Project-CETI/whale-tag-recovery/hardware/WhaleTagRecovery_3v2r1_BOM.xlsx

No. | Quantity | Comment | Designator | Footprint | Value | Manufacturer Part | Manufacturer | Supplier Part | Supplier | Datasheet | Description | LCSC Part Name | JLCPCB Part Class | Voltage Rated | Voltage | Add into BOM | LCSC Stock | LCSC Price | JLCPCB Stock | JLCPCB Price | Name
1 | 1 | MS621FE-FL11E | BT1 | MS621FE-FL11E |  |  |  |  |  |  |  |  |  |  |  | yes |  |  |  |  | MS621FE-FL11E
2 | 1 | 1uF | C1 | C0402 | 1uF | CC0402KRX5R7BB105 | YAGEO(国巨) | C325464 | LCSC | https://atta.szlcsc.com/upload/public/pdf/source/20181031/C325464_552E8C5A0F4FE3FC31E3609DB4A74E24.pdf | Capacitance: Tolerance:±10% Tolerance:±10% Voltage Rated: Temperature Coefficient: | 1uF ±10% 16V | Extended Part |  |  | yes | 106100 | 0.0038 | 22270 | 0.0249 | 1uF
3 | 1 | 10uF | C2 | C0603 |  | GRM188R60G106ME47D | muRata(村田) | C97885 | LCSC |  |  |  | ExtendedPart |  |  | yes | 1100 | 0.0171 | 1781 | 0.117 | 10uF
4 | 1 | 100nF | C4 | C0402 | 100nF | GCM155R71C104KA55J | muRata(村田) | C2655418 | LCSC | https://atta.szlcsc.com/upload/public/pdf/source/20210701/42090801FDE37D0E45AFF657247F4A08.pdf | Capacitance: Tolerance:±10% Tolerance:±10% Voltage Rated: Temperature Coefficient: | 100nF ±10% 16V | Extended Part |  |  | yes | 700 | 0.0058 | 4903 | 0.0388 | 100nF
5 | 1 | 100nF | C5 | C0402 |  | CC0402ZRY5V7BB104 | YAGEO(国巨) | C106209 | LCSC |  |  |  | ExtendedPart |  |  | yes | 511900 | 0.0013 | 94523 | 0.00825 | 100nF
6 | 2 | 1uF | C6,C15 | C0402 |  | GRM155R61E105KA12D | muRata(村田) | C77009 | LCSC |  |  |  | ExtendedPart |  |  | yes | 937595 | 0.0057 | 444510 | 0.0383 | 1uF
7 | 1 | 100uF | C7 | C1210 |  | GRM32ER60J107ME20L | muRata(村田) | C88154 | LCSC |  |  |  | ExtendedPart |  |  | yes | 112580 | 0.1098 | 26608 | 0.751 | 100uF
8 | 9 | 100nF | C8,C9,C10,C11,C12,C13,C14,C17,C23 | C0402 |  | GRM155R71C104KA88D | muRata(村田) | C71629 | LCSC |  |  |  | ExtendedPart |  |  | yes |  |  | 689637 | 0.00981 | 100nF
9 | 1 | 10nF | C16 | C0402 |  | GRM155R71H103KA88D | muRata(村田) | C77019 | LCSC |  |  |  | ExtendedPart |  |  | yes | 651884 | 0.0020 | 450964 | 0.0137 | 10nF
10 | 1 | 4.7uF | C18 | C0603 |  | GRM188R61A475KE15D | muRata(村田) | C71633 | LCSC |  |  |  | ExtendedPart |  |  | yes |  |  | 1607 | 0.0563 | 4.7uF
11 | 2 | 15pF | C19,C20 | C0402 |  | GJM1555C1H150FB01D | muRata(村田) | C441742 | LCSC |  |  |  | ExtendedPart |  |  | yes |  |  | 9774 | 0.134 | 15pF
12 | 2 | 6pF | C21,C22 | C0402 |  | GCM1555C1H6R0BA16D | muRata(村田) | C437443 | LCSC |  |  |  | ExtendedPart |  |  | yes | 800 | 0.0158 | 1091 | 0.106 | 6pF
13 | 4 | 0Ω | C,C28,D,L5 | R0402 | 0Ω | ERJ2GE0R00X | PANASONIC(松下) | C242160 | LCSC | https://atta.szlcsc.com/upload/public/pdf/source/20181106/C242160_CA6E41971DE5A1DCD79442F3CF334CD6.pdf | Type:Thick Film Resistors Resistance: Power(Watts): Overload Voltage (Max):- Temperature Coefficient:-100ppm/℃~+600ppm/℃ Temperature Coefficient:-100ppm/℃~+600ppm/℃ Operating Temperature Range:-55℃~+155℃ Operating Temperature Range:-55℃~+155℃,Type:Thick Film Resistors Resistance: Power(Watts): Overload Voltage (Max):- Temperature Coefficient:-100ppm/℃~+600ppm/℃ Temperature Coefficient:-100ppm/℃~+600ppm/℃ Operating Temperature Range:-55℃~+155℃ Operating Temperature Range:-55℃~+155℃ | 0Ω 100mW 厚膜电阻 | Extended Part |  |  | yes |  | 0.0036 | 0 | 0.024 | 0Ω
14 | 1 | SS14L | D1 | SMA_L4.4-W2.6-LS5.0-RD |  | SS14L_R1_00001 | PANJIT(强茂) | C125883 | LCSC |  |  |  | ExtendedPart |  |  | yes | 3300 | 0.0596 | 3536 | 0.399 | SS14L
15 | 1 | 16-213/BHC-ZL1M2B6Y/3T | D2 | LED0402-RD_BLUE |  | 16-213/BHC-ZL1M2B6Y/3T | EVERLIGHT(亿光) | C2844007 | LCSC |  |  |  | ExtendedPart |  |  | yes | 124060 | 0.0288 | 119474 | 0.193 | 16-213/BHC-ZL1M2B6Y/3T
16 | 1 | 16-213/SDRC/S530-A3/TR8 | D3 | LED0402-RD |  | 16-213SDRC/S530-A3/TR8 | EVERLIGHT(亿光) | C71911 | LCSC |  |  |  | ExtendedPart |  |  | yes |  |  | 21515 | 0.32 | 16-213/SDRC/S530-A3/TR8
17 | 2 | 1909763-1 | J1,J2 | ANT-SMD_1909763-1 |  | 1909763-1 | TEConnectivity(美国泰科) | C392444 | LCSC |  |  |  | ExtendedPart |  |  | yes | 10 | 0.2992 | 148 | 2.0463 | 1909763-1
18 | 1 | TC2030-IDC-NL | J3 | TC2030-IDC-NL |  |  |  |  |  |  |  |  |  |  |  | yes |  |  |  |  | TC2030-IDC-NL
19 | 1 | CASTELLATION-0.05&quot;-W/-TH | J4 | CASTELLATION-0.05\"-W/-TH |  |  |  |  |  |  |  |  |  |  |  | yes |  |  |  |  | CASTELLATION-0.05&quot;-W/-TH
20 | 1 | Ferrite Bead | L1 | L0603 | 120R | BLM18PG121SN1D | muRata(村田) | C14709 | LCSC |  |  |  | ExtendedPart |  |  | yes |  |  | 167327 | 0.0416 | Ferrite Bead
21 | 1 | CI160808-27NJ | L2 | IND_BOURNS_CI160808 |  |  |  |  |  |  |  |  |  |  |  | yes |  |  |  |  | CI160808-27NJ
22 | 1 | LQW15AN9N1J00D_ | L4 | INDC1006X60N |  |  |  |  |  |  |  |  |  |  |  | yes
23 | 2 | DMN65D8L-7 | Q1,Q2 | SOT-23-3_L3.0-W1.7-P0.95-LS2.9-BR |  | DMN65D8L-7 | DIODES(美台) | C155341 | LCSC |  |  |  | ExtendedPart |  |  | yes | 10500 | 0.0248 | 10693 | 0.169 | DMN65D8L-7
24 | 1 | SSM3J332R,LF | Q3 | SOT-23F_L2.9-W1.8-P0.95-LS2.4-BR |  | SSM3J332R,LF | TOSHIBA | C146367 | LCSC |  |  |  | ExtendedPart |  |  | yes | 101700 | 0.0438 | 89033 | 0.299 | SSM3J332R,LF
25 | 3 | 1k | R1,R2,R7 | R0603 |  |  |  |  |  |  |  |  |  |  |  | yes |  |  |  |  | 1k
26 | 1 | 10Ω | R3 | R0603 | 10Ω | ESR03EZPJ100 | ROHM(罗姆) | C253327 | LCSC | https://atta.szlcsc.com/upload/public/pdf/source/20180719/C253345_B76D5E071FE5F975028EF7B0C44FE2A9.pdf | Type:Thick Film Resistors Resistance: Tolerance:±5% Tolerance:±5% Power(Watts):250mW Overload Voltage (Max): Temperature Coefficient:±200ppm/℃ Temperature Coefficient:±200ppm/℃ Operating Temperature Range:-55℃~+155℃ Operating Temperature Range:-55℃~+155℃ | 厚膜电阻 10Ω ±5% 250mW | Extended Part |  |  | yes |  | 0.0076 | 447 | 0.0508 | 10Ω
27 | 3 | 10k | R4,R15,R30 | R0603 |  | RC0603FR-0710KL |  |  | LCSC |  |  |  |  |  |  | yes |  |  |  |  | 10k
28 | 2 | 0 Ohm | R5,R16 | R0603 |  | 0603WAF0000T5E |  |  | LCSC |  |  |  |  |  |  | yes |  |  |  |  | 0 Ohm
29 | 4 | 75k | R6,R12,R13,R14 | R0603 |  | RC0603FR-0775KL |  |  |  |  |  |  |  |  |  | yes |  |  |  |  | 75k
30 | 2 | 330Ω | R8,R9 | R0603 | 330Ω | RC0603JR-07330RL | YAGEO(国巨) | C105879 | LCSC | https://atta.szlcsc.com/upload/public/pdf/source/20170705/1499242708629.pdf | Type:Thick Film Resistors Resistance: Tolerance:±5% Tolerance:±5% Power(Watts): Overload Voltage (Max): Temperature Coefficient:±100ppm/℃ Temperature Coefficient:±100ppm/℃ Operating Temperature Range:-55℃~+155℃ Operating Temperature Range:-55℃~+155℃ | 厚膜电阻 330Ω ±5% 100mW | Extended Part |  |  | yes | 89392 | 0.0010 | 34052 | 0.00633 | 330Ω
31 | 1 | 10k | R24 | R0402 |  | TR0402D10KQ1025 |  |  | LCSC |  |  |  |  |  |  | yes |  |  |  |  | 10k
32 | 1 | 4.22k | R25 | R0402 |  | RT0402BRD074K22L |  |  | LCSC |  |  |  |  |  |  | yes |  |  |  |  | 4.22k
33 | 1 | 15k | R26 | R0402 |  | 0402WGF1502TCE |  |  | LCSC |  |  |  |  |  |  | yes |  |  |  |  | 15k
34 | 1 | DRA818V | U1 | DORJI_DRA818V |  |  |  |  |  |  |  |  |  |  |  | yes |  |  |  |  | DRA818V
35 | 1 | NEO-M9N-00B | U2 | GPSM-SMD_24P-L16.0-W12.2-P1.10-BL |  | NEO-M9N-00B | null | C5119087 | LCSC |  |  |  | ExtendedPart |  |  | yes |  | 41.1692 | 0 | 276 | NEO-M9N-00B
36 | 1 | {ManufacturerPart!} | U3 | LQFP-100_L14.0-W14.0-P0.50-LS16.0-BL |  | STM32U575VGT6 | ST(意法半导体) | C5270988 | LCSC |  |  | STM32U575VGT6 | ExtendedPart |  |  | yes | 6182 | 5.4415 | 3071 | 36.48 | {ManufacturerPart!}
37 | 1 | SKY65943-11 | U6 | MCM-10_L2.5-W2.5-P0.50-BL-EP |  | SKY65943-11 | SKYWORKS | C2654442 | LCSC |  | Frequency Range:1.559GHz~1.606GHz Frequency Range:1.559GHz~1.606GHz Applications:Galileo,GLONASS,GNSS,GPS | SKY65943-11 | Extended Part |  |  | yes |  | 15.6638 | 0 | 105 | SKY65943-11
38 | 1 | 32.768kHz | X1 | OSC-SMD_L3.2-W1.5 |  | X321532768KGD2SI | YXC(扬兴晶振) | C620155 | LCSC |  |  |  | ExtendedPart |  |  | yes | 114945 | 0.1826 | 42698 | 1.25 | 32.768kHz
39 | 1 | 16MHz | X2 | CRYSTAL-SMD_4P-L2.5-W2.0-BL-A |  | NX2520SA-16MHZ-STD-CSW-5 | NDK | C280836 | LCSC |  |  |  | ExtendedPart |  |  | yes | 5092 | 0.3790 | 5247 | 2.54 | 16MHz
