Project-CETI/whale-tag-recovery/(threads)

Thread 4 (2022-08-01):

Sleep RP2040 chip when not being used

SSModelGit, 2022-08-01:
Assuming no RX of APRS messages, we want to leverage the sleep capabilities of the RP2040 so that we are using as little power as possible. Ideally, we use a timer to set when the chip should wake up, and at all other times it hibernates at the lowest power mode.

kellyostrom, 2022-08-25:
This requires fixing an IRQ usage issue on the RP2040, currently when waking from the sleep it will eventually kernel panic for running out of available user IRQs. The lowlevel internal call for restoring the gpio IRQ after the sleep does not appear to be freeing properly, will need more investigation before this can be fully implemented in a way that rewakes the RP2040.

msalinoh, 2024-01-17:
Implementing low power mode is still relevant to STM32 based board.

Sources to wakeup during idle state:
1) receiving UART command from host board
1) critical battery voltage (switch to shutdown state)
1) WDT, failure to receive communication from host board in 10 minutes (switch to active state)

Sources to wakeup during active state:
1) transmit timer
1) receiving UART command from host board
1) receiving UART from GPS chip
1) critical battery voltage (switch to shutdown state)

Updated issue title

Thread 6 (2022-08-01):

Measure board power consumption with sleep modes enabled

SSModelGit, 2022-08-01:
When #3, #4, and #5 are implemented, hook up a meter and measure how much power is being consumed by the board to document what power levels we need to use.

kellyostrom, 2022-08-25:
With everything in a deep sleep/powered entirely down, we are at about 0.1Ws of passive consumption. It's possible we can get this even lower, but this is our deep sleep benchmark as of now.

Thread 8 (2022-08-01):

Add latitude frequency switch to Tag 2

SSModelGit, 2022-08-01:
- [ ] Compile a binary using the new `aprs.c` file with the old `swarm.c` file.
- [ ] Check that nothing breaks post compilation.
- [ ] Verify that the latitude frequency switch now occurs post compilation.

kellyostrom, 2022-08-25:
No longer using swarm

Closed 2022-08-25.

Thread 9 (2022-08-01):

Fix global variable use

SSModelGit, 2022-08-01:
Adapt the code to use less global variables and make memory access more controlled so that the eventual switch to state-machine-based interrupts does not cause errors.

kellyostrom, 2022-08-17:
Created constants file to store the important #defines and static consts that is then shared throughout the various configs

Closed 2022-08-17.

Thread 13 (2022-08-25):

PIO for APRS sine wave generation

kellyostrom, 2022-08-25:
Currently the sine wave for the APRS transmissions are using a simply loop functionality with a busy wait. There are some concerns that there is error delay accumulating from this as per #12, and if that's true, if the PIO could be used to generate the sine wave instead because of the higher precision in terms of timing. The PIO would allow better syncing with the clock to have a more accurate sine wave.

msalinoh, 2024-01-17:
No longer relevant to latest STM32 based recovery board. Sinewave generation handled via DAC DMA with clock scaling for precise timing.

Closed 2024-01-17.

Thread 14 (2022-08-25):

Compressed AX.25 messages for APRS

kellyostrom, 2022-08-25:
Currently we are using the standard message configuration for the AX.25 messages, however it may be beneficial to use the compressed message format to ensure the length of our transmission in terms of data is shorter. However, the positions in the compressed messages have less accuracy than the standard format.

msalinoh, 2024-01-17:
Compressed APRS location information now implemented.

Closed 2024-01-17.

Thread 19 (2024-01-17):

Implement WDT while in idle mode

msalinoh, 2024-01-17:
Currently the recovery board is placed into an idle state via uart command when the host whale tag detects it is in a dive as GPS and APRS communication is not possible underwater. Currently the only way out of this state is via uart command from the whale tag. This runs the risk that if the tag dies while on a dive, the recovery board will never become active making retrieval much more difficult.

- [ ] Implement a watchdog timer (WDT) that will automatically switch the tag into recovery mode after 10 minutes
- [ ] Reset WDT when we receive a valid uart command from the host whale tag
