Project-CETI/whale-tag-recovery/hardware/WhaleTagRecovery_3v2r1_Schematic.pdf

VDD 50 | PB12 51 PB13 52 PB14 53 PB15 54 PD8 55 PD9 56 PD10 57 PD11 58 PD12 59 PD13 60 PD14 61 PD15 62 PC6 63 PC7 64 PC8 65 PC9 66 PA8 67 PA9 68 PA10 69 PA11 70 PA12 71 PA13 72 VDDUSB 73 VSS 74 VDD 75 PA14 76 PA15 77 PC10 78 PC11 79 PC12 80 PD0 81 PD1 82 PD2 83 PD3 84 PD4 85 PD5 86 PD6 87 PD7 88 PB3 89 PB4 90 PB5 91 PB6 92 PB7 93 PH3-BOOTO 94 PB8 95 PB9 96 PE0 97 PE1 98 VSS 99 VDD 100
LSE Crystal | HSE Crystal

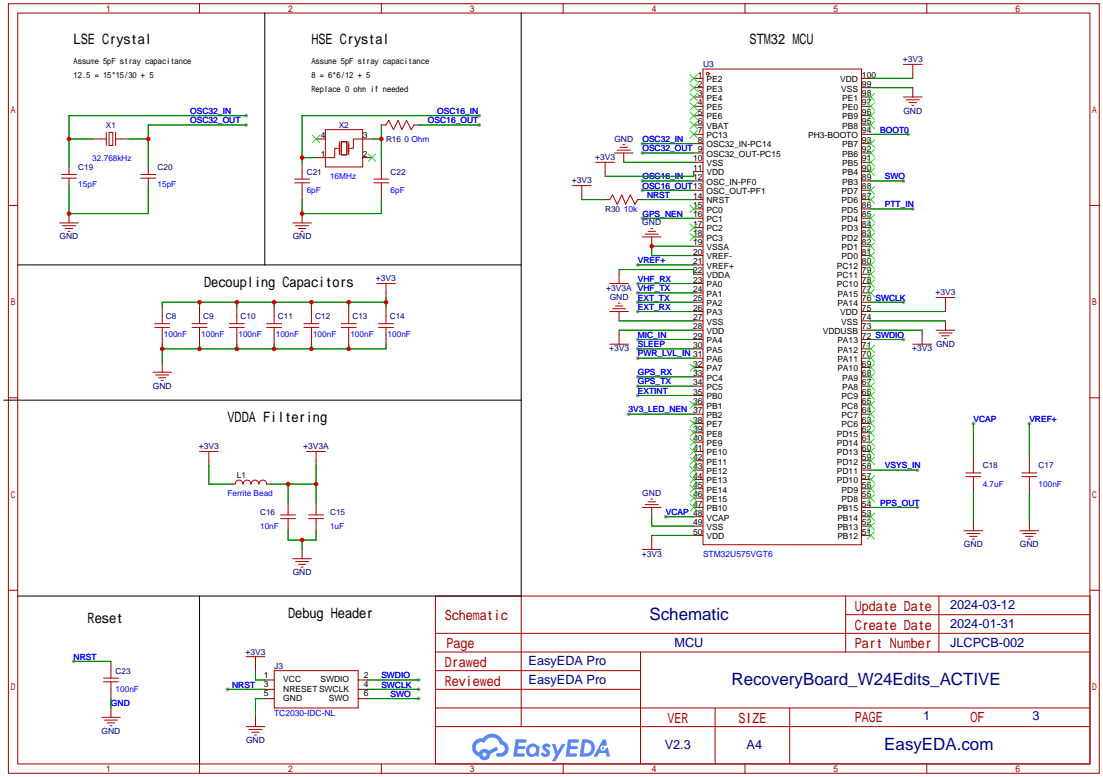
[picture p3: page 1]

Assume 5pF stray capacitance
Replace 0 ohm if needed

VHF Transceiver | GPS Module

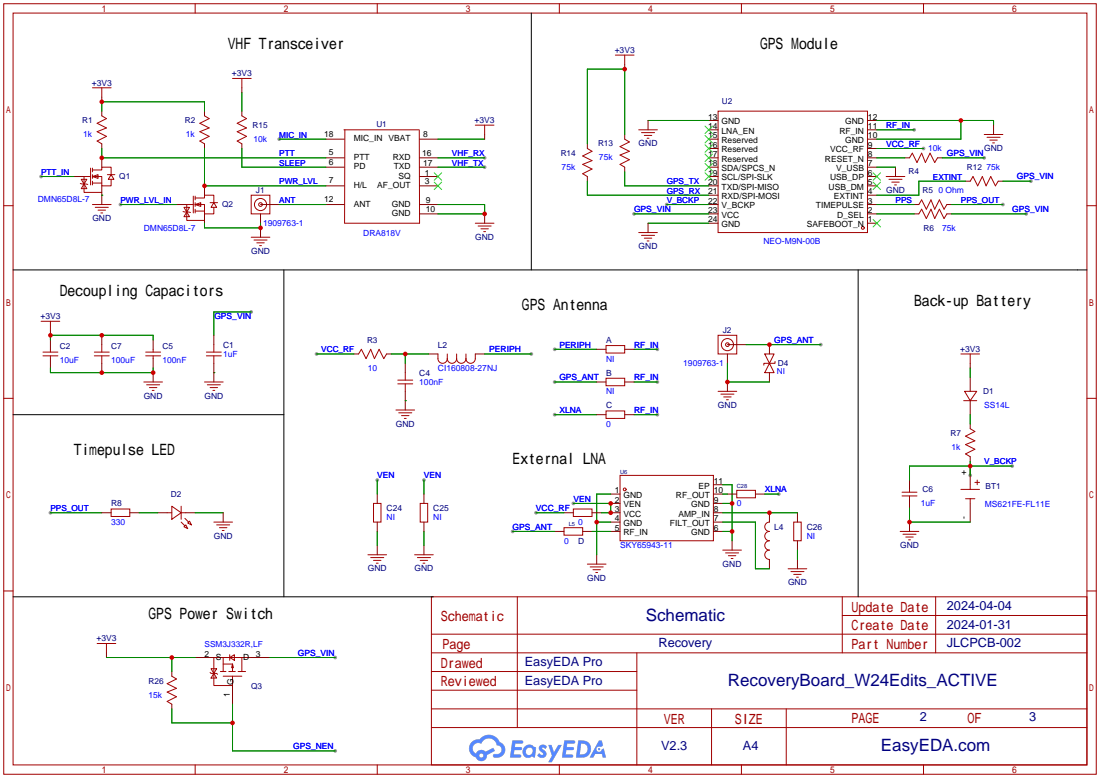
[picture p4: page 2]

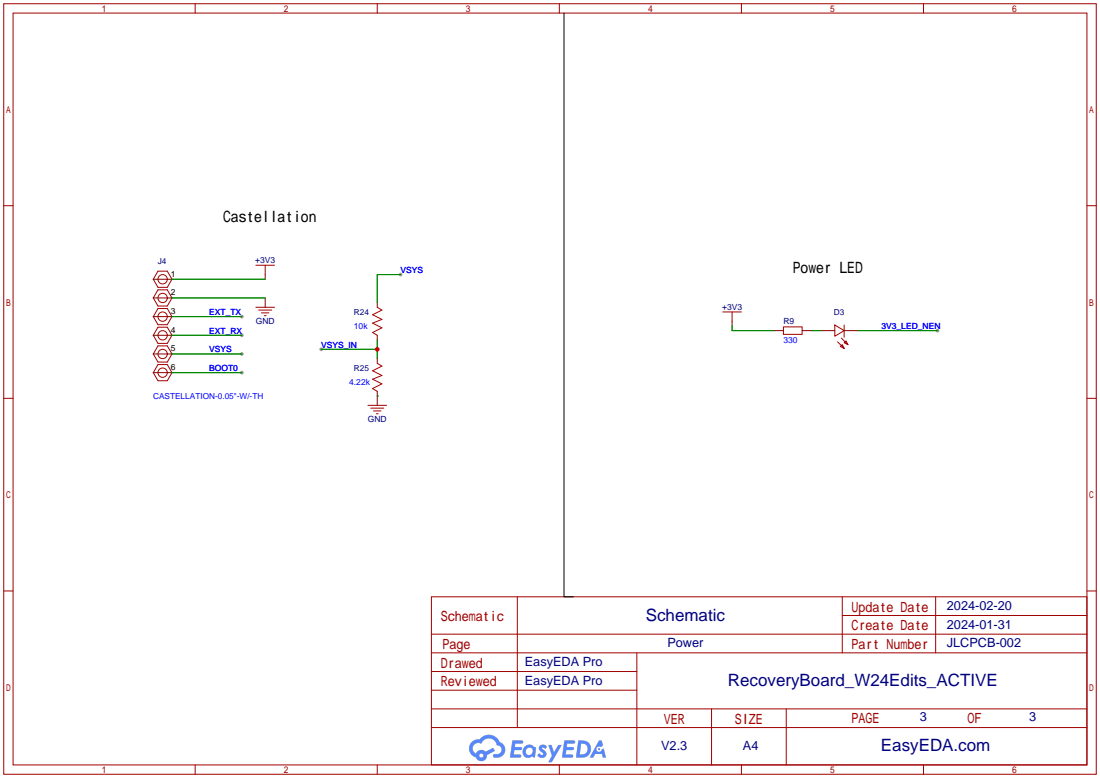
[picture p5: page 3]
