Project-CETI/whale-tag-recovery/(list of files, drawings)

Other design files:
hardware/WhaleTagRecovery_3v2r1_EasyEDA.epro
