Project-CETI/whale-tag-recovery/WhaleTagRecovery/Core/Src/main.c

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
/* Includes ------------------------------------------------------------------*/
#include "app_threadx.h"
#include "main.h"

/* USER CODE BEGIN Includes */
#include "config.h"
#include "Recovery Inc/Gps.h"
#include "Comms Inc/PiComms.h"
/* USER CODE END Includes */

/* USER CODE BEGIN PM */
#define BOOTLOADER_ADDRESS     0x0BF90000
/* USER CODE END PM */

ADC_HandleTypeDef hadc4;

DAC_HandleTypeDef hdac1;
DMA_NodeTypeDef Node_GPDMA1_Channel1;
DMA_QListTypeDef List_GPDMA1_Channel1;
DMA_HandleTypeDef handle_GPDMA1_Channel1;

TIM_HandleTypeDef htim2;

UART_HandleTypeDef huart4;
UART_HandleTypeDef huart2;
UART_HandleTypeDef huart3;
DMA_HandleTypeDef handle_GPDMA1_Channel2;
DMA_NodeTypeDef Node_GPDMA1_Channel0;
DMA_QListTypeDef List_GPDMA1_Channel0;
DMA_HandleTypeDef handle_GPDMA1_Channel0;

/* USER CODE BEGIN PV */
VHF_HandleTypdeDef vhf = {
	.huart = &huart4,
	.pd = 	{.port = APRS_PD_GPIO_Port,  .pin = APRS_PD_Pin},
	.h_l = 	{.port = APRS_H_L_GPIO_Port, .pin = APRS_H_L_Pin},
	.ptt = 	{.port = VHF_PTT_GPIO_Port,  .pin = VHF_PTT_Pin},
	.state = VHF_STATE_SLEEP,
	.power_level = VHF_POWER_HIGH,
	.config = {
		.tx_freq_MHz = 144.3900f,
		.rx_freq_MHz = 144.3900f,
		.volume = VHF_VOLUME_LEVEL,
	},
};
/* USER CODE END PV */

void SystemClock_Config(void);
static void SystemPower_Config(void);
static void MX_GPIO_Init(void);
static void MX_GPDMA1_Init(void);
static void MX_DAC1_Init(void);
static void MX_TIM2_Init(void);
static void MX_UART4_Init(void);
static void MX_USART3_UART_Init(void);
static void MX_USART2_UART_Init(void);
static void MX_ADC4_Init(void);
static void MX_ICACHE_Init(void);
/* USER CODE BEGIN 0 */
void HAL_UARTEx_RxEventCallback(UART_HandleTypeDef *huart, uint16_t Size){
	//restarts the DMA listening of the UART rx (next 247 bytes)
	if ( huart->Instance == USART2 ) {
		Pi_RxEventCallback(huart, Size);
	} else if(huart->Instance == USART3){
//		GPS_RxEventCallback(huart, Size);
	}
	return;
}

/* USER CODE END 0 */

/**
  * @brief  The application entry point.
  * @retval int
  */
int main(void)
{

  /* MCU Configuration--------------------------------------------------------*/

  /* Reset of all peripherals, Initializes the Flash interface and the Systick. */
  HAL_Init();

  /* Configure the System Power */
  SystemPower_Config();

  /* Configure the system clock */
  SystemClock_Config();

  /* USER CODE BEGIN SysInit */
#if USB_BOOTLOADER_ENABLED
	// configure PA10 as input
	// read PIN PA10 value, if low enter bootloader
	__HAL_RCC_GPIOA_CLK_ENABLE();
	 GPIO_InitTypeDef GPIO_InitStruct = {
			 .Pin = USB_BOOT_EN_Pin,
			 .Mode = GPIO_MODE_INPUT,
			 .Pull = GPIO_PULLUP
	 };
	 HAL_GPIO_Init(USB_BOOT_EN_GPIO_Port, &GPIO_InitStruct);
	GPIO_PinState bootloader_val = HAL_GPIO_ReadPin(USB_BOOT_EN_GPIO_Port, USB_BOOT_EN_Pin);
	HAL_GPIO_DeInit(USB_BOOT_EN_GPIO_Port, USB_BOOT_EN_Pin);
	__HAL_RCC_GPIOA_CLK_DISABLE(); //disable GPIO clock
	/* JUMP TO SYSTEM MEMORY BOOTLOADER IF PIN IS LOW*/
	if (bootloader_val == GPIO_PIN_RESET) {
		/*Configure GPIO pin Output Level */
		__HAL_RCC_GPIOB_CLK_ENABLE();
		HAL_GPIO_WritePin(PWR_LED_NEN_GPIO_Port, PWR_LED_NEN_Pin, GPIO_PIN_SET);
		GPIO_InitStruct = (GPIO_InitTypeDef){
			.Pin = PWR_LED_NEN_Pin,
			.Mode = GPIO_MODE_OUTPUT_PP,
			.Pull = GPIO_NOPULL,
			.Speed = GPIO_SPEED_FREQ_LOW
		};
		HAL_GPIO_Init(PWR_LED_NEN_GPIO_Port, &GPIO_InitStruct);
		for(int i = 0; i < 2*5; i++){
			HAL_GPIO_TogglePin(PWR_LED_NEN_GPIO_Port, PWR_LED_NEN_Pin);
			HAL_Delay(250);
		}
		HAL_GPIO_DeInit(PWR_LED_NEN_GPIO_Port, PWR_LED_NEN_Pin);
		__HAL_RCC_GPIOB_CLK_DISABLE();
		HAL_DeInit();
		uint32_t BootloaderAddress = *(__IO uint32_t*) (BOOTLOADER_ADDRESS + 4);
		void (* JumpToBootloader)(void) = (void(*)(void)) BootloaderAddress;
		JumpToBootloader();
	}
#endif
  /* USER CODE END SysInit */

  /* Initialize all configured peripherals */
  MX_GPIO_Init();
  MX_GPDMA1_Init();
  MX_DAC1_Init();
  MX_TIM2_Init();
  MX_UART4_Init();
  MX_USART3_UART_Init();
  MX_USART2_UART_Init();
  MX_ADC4_Init();
  MX_ICACHE_Init();
  /* USER CODE BEGIN 2 */
#if BATTERY_MONITOR_ENABLED
  //********************************REQUIRED FOR ADC USE DO NOT REMOVE********************************
  HAL_PWREx_EnableVddA();
#endif
  /* USER CODE END 2 */

  MX_ThreadX_Init();

  /* We should never get here as control is now taken by the scheduler */

  /* Infinite loop */
  /* USER CODE BEGIN WHILE */
  while (1)
  {
    /* USER CODE END WHILE */

    /* USER CODE BEGIN 3 */
  }
  /* USER CODE END 3 */
}

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
/* USER CODE BEGIN 4 */
//Fake timer 2 init function so we can change the period value during runtime
void MX_TIM2_Fake_Init(uint8_t newPeriod){

  TIM_ClockConfigTypeDef sClockSourceConfig = {0};
  TIM_MasterConfigTypeDef sMasterConfig = {0};

  htim2.Instance = TIM2;
  htim2.Init.Prescaler = 16 - 1;
  htim2.Init.CounterMode = TIM_COUNTERMODE_UP;
  htim2.Init.Period = newPeriod - 1;
  htim2.Init.ClockDivision = TIM_CLOCKDIVISION_DIV1;
  htim2.Init.AutoReloadPreload = TIM_AUTORELOAD_PRELOAD_DISABLE;
  if (HAL_TIM_Base_Init(&htim2) != HAL_OK)
  {
	Error_Handler();
  }
  sClockSourceConfig.ClockSource = TIM_CLOCKSOURCE_INTERNAL;
  if (HAL_TIM_ConfigClockSource(&htim2, &sClockSourceConfig) != HAL_OK)
  {
	Error_Handler();
  }
  sMasterConfig.MasterOutputTrigger = TIM_TRGO_UPDATE;
  sMasterConfig.MasterSlaveMode = TIM_MASTERSLAVEMODE_DISABLE;
  if (HAL_TIMEx_MasterConfigSynchronization(&htim2, &sMasterConfig) != HAL_OK)
  {
	Error_Handler();
  }
}
/* USER CODE END 4 */

/**
  * @brief  Period elapsed callback in non blocking mode
  * @note   This function is called  when TIM6 interrupt took place, inside
  * HAL_TIM_IRQHandler(). It makes a direct call to HAL_IncTick() to increment
  * a global variable "uwTick" used as application time base.
  * @param  htim : TIM handle
  * @retval None
  */
void HAL_TIM_PeriodElapsedCallback(TIM_HandleTypeDef *htim)
{
  if (htim->Instance == TIM6) {
    HAL_IncTick();
  }
}

/**
  * @brief  This function is executed in case of error occurrence.
  * @retval None
  */
void Error_Handler(void)
{
  /* USER CODE BEGIN Error_Handler_Debug */
  /* User can add his own implementation to report the HAL error return state */
  __disable_irq();
  while (1)
  {
  }
  /* USER CODE END Error_Handler_Debug */
}

#ifdef  USE_FULL_ASSERT
/**
  * @brief  Reports the name of the source file and the source line number
  *         where the assert_param error has occurred.
  * @param  file: pointer to the source file name
  * @param  line: assert_param error line source number
  * @retval None
  */
void assert_failed(uint8_t *file, uint32_t line)
{
  /* USER CODE BEGIN 6 */
  /* User can add his own implementation to report the file name and line number,
     ex: printf("Wrong parameters value: file %s on line %d\r\n", file, line) */
  /* USER CODE END 6 */
}
#endif /* USE_FULL_ASSERT */
