Project-CETI/whale-tag-recovery/WhaleTagRecovery/WhaleTagRecovery.ioc

Mcu.UserName=STM32U575VGTx
PA0.GPIO_Label=VHF_TX
PA0.Signal=UART4_TX
PA1.GPIO_Label=VHF_RX
PA1.Signal=UART4_RX
PA2.GPIO_Label=EXT_TX
PA2.Signal=USART2_TX
PA3.GPIO_Label=EXT_RX
PA3.Signal=USART2_RX
PA4.Signal=COMP_DAC11_group
PA5.GPIO_Label=APRS_PD
PA5.Signal=GPIO_Output
PA6.GPIO_Label=APRS_H_L
PA6.Signal=GPIO_Output
PB0.GPIO_Label=GPS_EXTINT
PB0.Signal=GPXTI0
PB2.GPIO_Label=PWR_LED_NEN
PB2.Signal=GPIO_Output
PC1.GPIO_Label=GPS_NEN
PC1.Signal=GPIO_Output
PC4.GPIO_Label=GPS_TX
PC4.Signal=USART3_TX
PC5.GPIO_Label=GPS_RX
PC5.Signal=USART3_RX
PD11.GPIO_Label=VSYS_SENSE
PD11.Signal=SharedAnalog_PD11
PD5.GPIO_Label=VHF_PTT
PD5.Signal=GPIO_Output
