Project-CETI/whale-tag-recovery/WhaleTagRecovery/Core/Inc/main.h

#define GPS_NEN_Pin GPIO_PIN_1
#define GPS_NEN_GPIO_Port GPIOC
#define VHF_TX_Pin GPIO_PIN_0
#define VHF_TX_GPIO_Port GPIOA
#define VHF_RX_Pin GPIO_PIN_1
#define VHF_RX_GPIO_Port GPIOA
#define EXT_TX_Pin GPIO_PIN_2
#define EXT_TX_GPIO_Port GPIOA
#define EXT_RX_Pin GPIO_PIN_3
#define EXT_RX_GPIO_Port GPIOA
#define APRS_PD_Pin GPIO_PIN_5
#define APRS_PD_GPIO_Port GPIOA
#define APRS_H_L_Pin GPIO_PIN_6
#define APRS_H_L_GPIO_Port GPIOA
#define GPS_TX_Pin GPIO_PIN_4
#define GPS_TX_GPIO_Port GPIOC
#define GPS_RX_Pin GPIO_PIN_5
#define GPS_RX_GPIO_Port GPIOC
#define GPS_EXTINT_Pin GPIO_PIN_0
#define GPS_EXTINT_GPIO_Port GPIOB
#define PWR_LED_NEN_Pin GPIO_PIN_2
#define PWR_LED_NEN_GPIO_Port GPIOB
#define VSYS_SENSE_Pin GPIO_PIN_11
#define VSYS_SENSE_GPIO_Port GPIOD
#define VHF_PTT_Pin GPIO_PIN_5
#define VHF_PTT_GPIO_Port GPIOD
