Project-CETI/whale-tag-recovery/WhaleTagRecovery/Core/Src/app_threadx.c

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

/* Includes ------------------------------------------------------------------*/
#include "app_threadx.h"

/* USER CODE BEGIN Includes */
#include "Lib Inc/threads.h"
#include "Recovery Inc/Aprs.h"
#include "Recovery Inc/FishTracker.h"
#include <stdint.h>
/* USER CODE END Includes */

/* USER CODE BEGIN PV */
extern Thread_HandleTypeDef threads[NUM_THREADS];
/* USER CODE END PV */

/**
  * @brief  Application ThreadX Initialization.
  * @param memory_ptr: memory pointer
  * @retval int
  */
UINT App_ThreadX_Init(VOID *memory_ptr)
{
  UINT ret = TX_SUCCESS;
  /* USER CODE BEGIN App_ThreadX_MEM_POOL */

	//Initialize thread list so we can create threads
	threadListInit();

	//loop through each thread in the list, allocate the memory and create the stack
	for (uint8_t index = 0; index < NUM_THREADS; index++){

	  VOID * pointer = threads[index].thread_stack_start;
	  // Allocate memory pool
	  TX_BYTE_POOL* byte_pool = (TX_BYTE_POOL*) memory_ptr;
	  ret = tx_byte_allocate(byte_pool, &pointer, threads[index].config.thread_stack_size, TX_NO_WAIT);

  /* USER CODE END App_ThreadX_MEM_POOL */
  /* USER CODE BEGIN App_ThreadX_Init */
	  tx_thread_create(
			  &threads[index].thread,
			  threads[index].config.thread_name,
			  threads[index].config.thread_entry_function,
			  threads[index].config.thread_input,
			  threads[index].thread_stack_start,
			  threads[index].config.thread_stack_size,
			  threads[index].config.priority,
			  threads[index].config.preempt_threshold,
			  threads[index].config.timeslice,
			  threads[index].config.start);
	}

	//TEMP: start the correct thread
#if USE_FISHTRACKER
		tx_thread_resume(&threads[FISHTRACKER_THREAD].thread);
#else
		tx_thread_resume(&threads[STATE_MACHINE_THREAD].thread);
#endif
  /* USER CODE END App_ThreadX_Init */

  return ret;
}

  /**
  * @brief  Function that implements the kernel's initialization.
  * @param  None
  * @retval None
  */
void MX_ThreadX_Init(void)
{
  tx_kernel_enter();

}

/**
  * @brief  App_ThreadX_LowPower_Timer_Setup
  * @param  count : TX timer count
  * @retval None
  */
void App_ThreadX_LowPower_Timer_Setup(ULONG count)
{
  /* USER CODE BEGIN  App_ThreadX_LowPower_Timer_Setup */

  /* USER CODE END  App_ThreadX_LowPower_Timer_Setup */
}

/**
  * @brief  App_ThreadX_LowPower_Enter
  * @param  None
  * @retval None
  */
void App_ThreadX_LowPower_Enter(void)
{
}

/**
  * @brief  App_ThreadX_LowPower_Exit
  * @param  None
  * @retval None
  */
void App_ThreadX_LowPower_Exit(void)
{
}

/**
  * @brief  App_ThreadX_LowPower_Timer_Adjust
  * @param  None
  * @retval Amount of time (in ticks)
  */
ULONG App_ThreadX_LowPower_Timer_Adjust(void)
{
  /* USER CODE BEGIN  App_ThreadX_LowPower_Timer_Adjust */
  return 0;
  /* USER CODE END  App_ThreadX_LowPower_Timer_Adjust */
}
