Project-CETI/whale-tag-recovery/testing/DirectSwarmTests/direct_swarm_connect/direct_swarm_connect.ino

#include "pico/stdlib.h"
#include <stdio.h>

#define MAX_SWARM_MSG_LEN 500

char modem_wr_buf[MAX_SWARM_MSG_LEN];
int modem_wr_buf_pos = 0;

char modem_rd_buf[MAX_SWARM_MSG_LEN];
int modem_rd_buf_pos = 0;
int buf_len = 0;

//char testString[MAX_SWARM_MSG_LEN] = "$RT 1";
char endNmeaString = '*';
uint8_t nmeaCS;

bool bootConfirmed = false;
bool initDTAck = false;

uint8_t nmeaChecksum(const char *sz, size_t len) {
  size_t i = 0;
  uint8_t cs;
  if (sz[0] == '$')
    i++;
  for (cs = 0; (i < len) && sz [i]; i++)
    cs ^= ((uint8_t) sz[i]);
  return cs;
}

int parseModemOutput() {
  if (!bootConfirmed) {
    if (buf_len != 21) {
      return 0; // Can't be BOOT,RUNNING message
    }
    if (modem_rd_buf[6] != 'B') {
      return 0; // Not BOOT sequence
    }
    if (modem_rd_buf[buf_len-1] != 'a') {
      return 0; // Not the right checksum
    }
    bootConfirmed = true;
    return 0;
  }
  if (!initDTAck) {
    if (modem_rd_buf[16] != '6') {
      return 0;
    }
    initDTAck = true;
    return 0;
  }
  return 0;
}

void readFromModem() {
  if (Serial1.available()) {
    modem_rd_buf[modem_rd_buf_pos] = Serial1.read();
    
    if (modem_rd_buf[modem_rd_buf_pos] != '\n') {
      modem_rd_buf_pos++;
    }
    else {
      modem_rd_buf[modem_rd_buf_pos] = '\0';
      buf_len = modem_rd_buf_pos;
      modem_rd_buf_pos = 0;
      Serial.println(modem_rd_buf);
      parseModemOutput();
    }
  }
}

void serialCopyToModem() {
  if (Serial.available()) {
    modem_wr_buf[modem_wr_buf_pos] = Serial.read();
    
    if (modem_wr_buf[modem_wr_buf_pos] != '\n') {
      modem_wr_buf_pos++;
    }
    else {
      modem_wr_buf[modem_wr_buf_pos] = '\0';
      modem_wr_buf_pos = 0;
      if (modem_wr_buf[0] == '$') {
        writeToModem(modem_wr_buf);
      }
    }
  }
}

void writeToModem(char *sz) {
  nmeaCS = nmeaChecksum(sz, strlen(sz));
  Serial.printf("[SENT] %s%c%X\n",sz,endNmeaString,nmeaCS);
  Serial1.printf("%s%c%X\n",sz,endNmeaString,nmeaCS);
}

void getRxTestOutput() {
  writeToModem("$RT 1");
}

void getQCount() {
  writeToModem("$MT C=U");
}

void txSwarm() {
  if (initDTAck) {
    Serial.print("Transmitting ...");
  }
}

void setup() {
  // put your setup code here, to run once:
  Serial.begin(115200);
  Serial1.setTX(0);
  Serial1.setRX(1);
  Serial1.begin(115200);
  while(!bootConfirmed) {
    readFromModem();
  }
  while(!initDTAck) {
    serialCopyToModem();
    readFromModem();
  }
  getRxTestOutput();
  getQCount();
  writeToModem("$TD \"Test 1\"");
  writeToModem("$TD \"Test 2\"");
  writeToModem("$TD \"Test 3\"");
}

void loop() {
  // put your main code here, to run repeatedly:
  serialCopyToModem();
  readFromModem();
}
