Project-CETI/whale-tag-recovery/(commit log)

2022-03-23 Initial code and SPI testing
2022-04-19 adds platformio.ini for pico using https://github.com/earlephilhower/arduino-pico.git
2022-04-19 Added working recovery board APRS code
2022-04-20 move arduino files to be openable
2022-05-13 add LED indication for packet queuing success
2022-05-31 Clearing buffers and printing error messages
2022-06-07 Fixed file structures for Arduino IDE's esoteric desires
2022-06-07 Full logging of Swarm attempts via uart
2022-06-10 Minor changes to probe the actual modem output
2022-06-10 Bare-bones functional replacement of sparkfun lib
    [direct_swarm_connect.ino]
2022-06-10 Adding afternoon log with smaller antenna@SEC
2022-06-16 Current board code w/APRS+SWARM(direct)
2022-06-17 Adding prelim uart comms to main tag
2022-06-21 detected crc errors in aprs transmission
    [RB1V0-DirectSwarm-wAPRS.ino]
2022-06-22 trials of uart comms to main tag
2022-06-23 Updating uart tag communications
2022-06-28 prepping for switch to rp2040 sdk
2022-07-01 fixed small bug in vhf initializing
    [RB1V0-DirectSwarm-wAPRS.ino]
2022-07-07 Cleaning up main branch to be best possible version
    [aprs-delay-param-breakdown.csv]
2022-07-07 Finally removing Arduino as main section
2022-08-17 Solved dra818v config problem
    [main.c, vhf.c]
2022-08-17 Ditched integrated submodule approach, restructured repo
    [aprs-delay-param-breakdown.csv]
2022-08-17 Finished frequency switching based on GPS lat data
2022-08-17 Adding debug method to plot dma data
2022-08-17 fixed dma printf output
    [gps.c, main.c]
2022-08-17 Adding fish tracker VHF transmissions to recovery board
2022-08-17 Adding general 'pico' and 'all' targets to build structure
2022-08-17 Fixed GPS readout structure
    [gps.c]
2022-08-17 Trying to fix aprs (yet again)
    [aprs.c, gps.c, main.c, vhf.c]
2022-08-17 Fix attempts pt 3
    [aprs.c, main.c]
2022-08-17 Something is happening. but technically timers are up
2022-08-17 Reverts APRS operation from IRQs, avoids odd busy_wait behavior
    [gps.c, main.c]
2022-08-17 Adding bin for michael's board (J73MAB)
2022-08-17 Fixzed issue with the fish tracker being too fast to read gps data
    [main.c]
2022-08-17 Removing binary because git won't let me for some reason
    [main.c]
2022-08-25 Fixed the local build issues finally
    [main.c, sleep.h]
2022-12-13 Found a bug in how we determine the presence of simulated coordinates
    [main.c]
2023-03-15 Update README.md
    clarifying a couple of points.
2023-08-10 removed old code
    [aprs-delay-param-breakdown.csv]
2023-08-10 systick timer
2023-08-10 dac and timer config
2023-08-17 added threads lib files and fishtracker
2023-08-17 added schematic changes to ioc
2023-08-19 written transmit comms thread
2023-08-21 non working adc conversions
2023-08-22 working battery monitoring
2023-09-18 sync ioc to schematic
2023-09-18 Enable GPS Power
2023-09-22 Reset to bootloader if USB_BOOT_EN low for 10 sec
    [PiCommsRX.c, main.c, state_machine.c, state_machine.h]
2023-09-25 include hardware files
    [RecoveryBoard_3v1r1_BOM.xlsx]
2023-09-28 heartbeat LED, disable battery monitor
2023-10-03 rework pi uart communication
    [Aprs.c, Aprs.h, AprsPacket.c, AprsPacket.h, GPS.c, GPS.h, PiComms.h, PiCommsRX.c]
2024-01-17 enable battery monitoring
2024-05-22 replace hardware files
    [RecoveryBoard_3v1r1_BOM.xlsx, WhaleTagRecovery_3v2r1_BOM.xlsx, WhaleTagRecovery_3v2r1_EasyEDA.epro]
2024-05-22 update schematic
2024-08-20 update .ioc for tag v2_3, and "ping" command to recovery board
2024-08-24 GPS collection moved to dma
2025-01-22 remove gps filtering
2025-07-01 recovery board reliability
2025-07-08 disable battery monitoring
2025-07-10 recovery reset gps dma on wake/sleep
    [GPS.c, PiCommsRX.c, WhaleTagRecovery.ioc, main.c]
